FlyingDomotic/ChargeurBalastArret/ChargeurBallast_schema.jpg

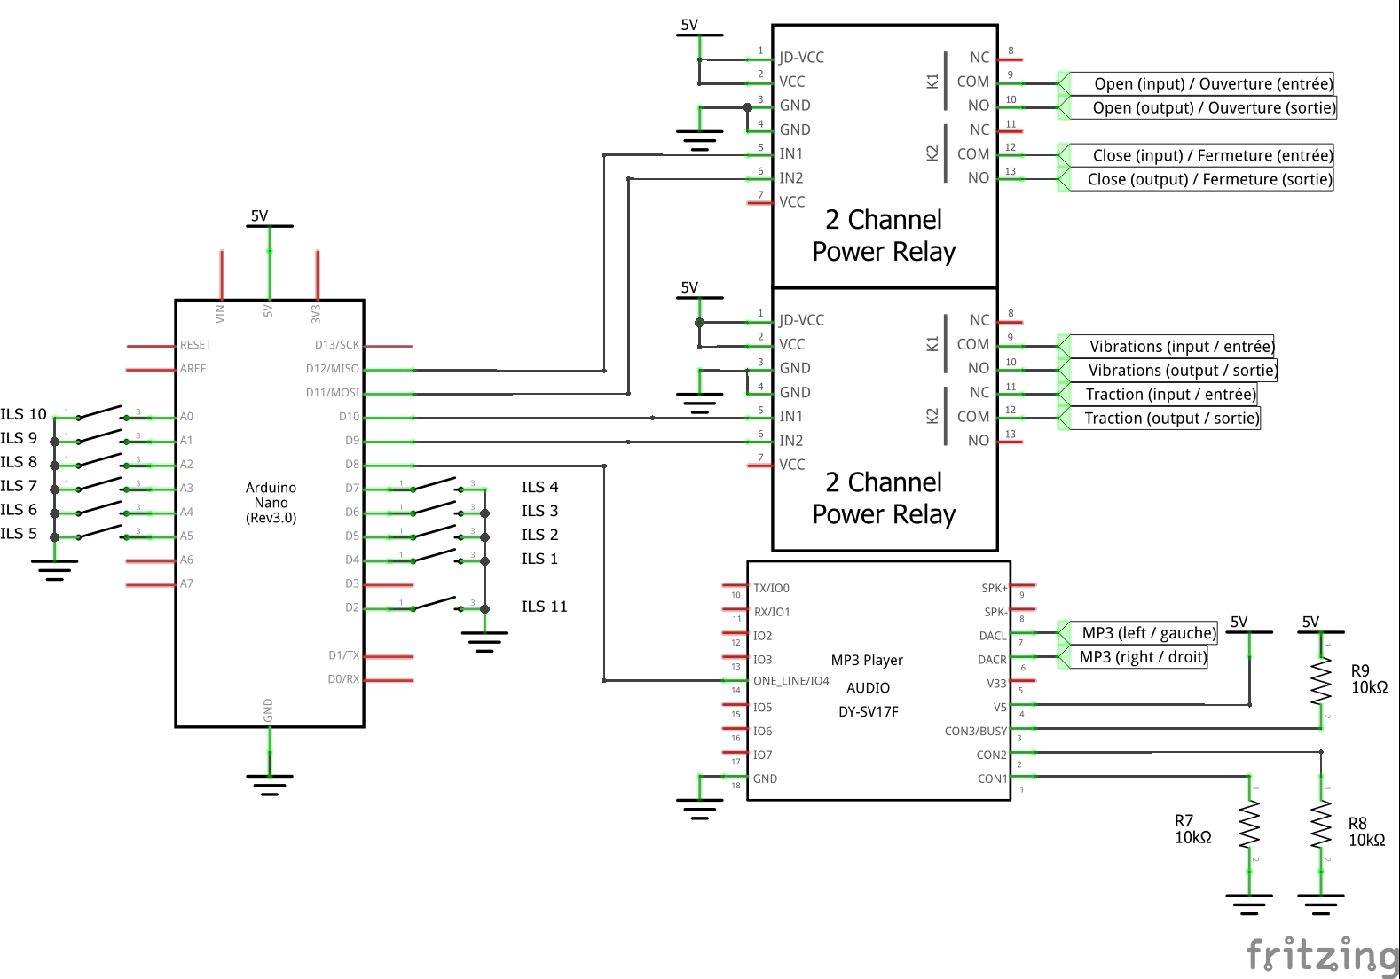
ChargeurBallast_schema.jpg
