FlyingDomotic/ChargeurBalastArret/(commit log)

2026-03-07 Add <ESC> as emergency stop
2026-03-07 Add current values in help message
2026-03-26 Add reference to hall sensors
2026-04-02 Add MP3 sound samples
2026-04-02 Deactivate ILS debug trace when module not active
